nerella2/ECE445Journal/PCB/kb42nerella2_alarm.kicad_pcb

## KiCad design PCB/kb42nerella2_alarm.kicad_pcb (2024-12-12)

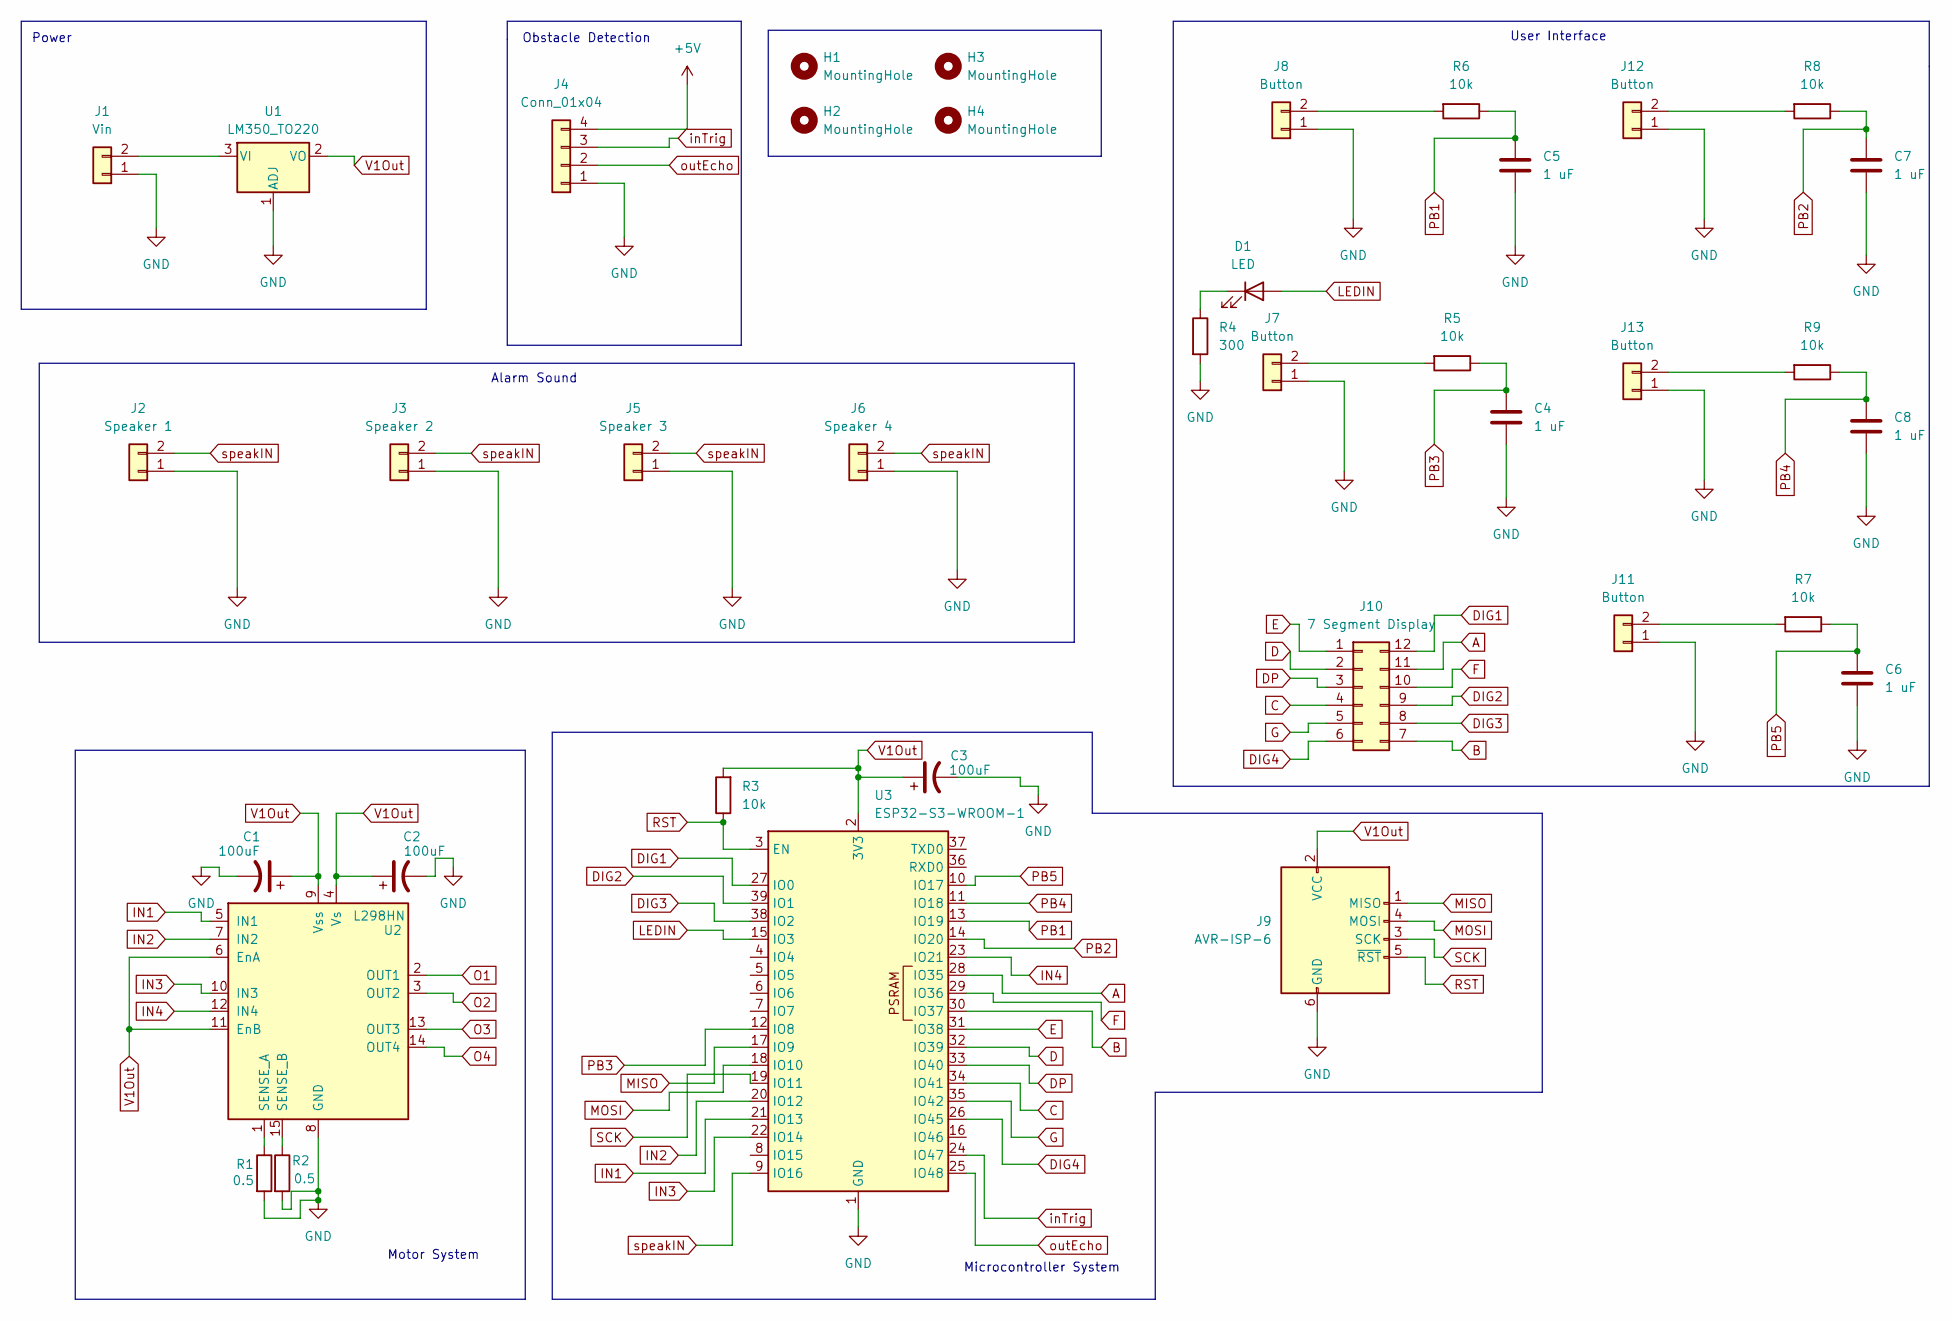
[picture p25: schematic kb42nerella2_alarm.kicad_sch]

Parts:
C1, C2, C3: 100uF; C_0805_2012Metric_Pad1.18x1.45mm_HandSolder
C4, C5, C6, C7, C8: 1 uF; C_0805_2012Metric_Pad1.18x1.45mm_HandSolder
D1: LED; Molex_KK-254_AE-6410-02A_1x02_P2.54mm_Vertical
H1, H2, H3, H4: MountingHole; MountingHole_3.2mm_M3
J1: Vin; Molex_KK-254_AE-6410-02A_1x02_P2.54mm_Vertical
J2: Speaker 1; Molex_KK-254_AE-6410-02A_1x02_P2.54mm_Vertical
J3: Speaker 2; Molex_KK-254_AE-6410-02A_1x02_P2.54mm_Vertical
J4: Conn_01x04; Molex_KK-254_AE-6410-04A_1x04_P2.54mm_Vertical
J5: Speaker 3; Molex_KK-254_AE-6410-02A_1x02_P2.54mm_Vertical
J6: Speaker 4; Molex_KK-254_AE-6410-02A_1x02_P2.54mm_Vertical
J7, J8, J11, J12, J13: Button; Molex_KK-254_AE-6410-02A_1x02_P2.54mm_Vertical
J9: AVR-ISP-6; IDC-Header_2x03_P2.54mm_Vertical
J10: 7 Segment Display; IDC-Header_2x06_P2.54mm_Vertical
R1, R2: 0.5; R_0805_2012Metric_Pad1.20x1.40mm_HandSolder
R3, R5, R6, R7, R8, R9: 10k; R_0805_2012Metric_Pad1.20x1.40mm_HandSolder
R4: 300; R_0805_2012Metric_Pad1.20x1.40mm_HandSolder
U1: LM350_TO220; TO-220-3_Vertical
U2: L298HN; TO-220-15_P2.54x2.54mm_StaggerOdd_Lead5.84mm_TabDown
U3: ESP32-S3-WROOM-1

Connections:
+5V: J4.4
A: J10.11, U3.28 (IO35)
B: J10.7, U3.30 (IO37)
C: J10.4, U3.34 (IO41)
D: J10.2, U3.32 (IO39)
DIG1: J10.12, U3.27 (IO0)
DIG2: J10.9, U3.39 (IO1)
DIG3: J10.8, U3.38 (IO2)
DIG4: J10.6, U3.26 (IO45)
DP: J10.3, U3.33 (IO40)
E: J10.1, U3.31 (IO38)
F: J10.10, U3.29 (IO36)
G: J10.5, U3.35 (IO42)
GND: C1.2, C2.2, C3.2, C4.2, C5.2, C6.2, C7.2, C8.2, J1.1, J2.1, J3.1, J4.1, J5.1, J6.1, J7.1, J8.1, J9.6 (GND), J11.1, J12.1, J13.1, R1.2, R2.2, R4.2, U1.1 (ADJ), U2.8 (GND), U3.1 (GND), U3.40 (GND), U3.41 (GND)
IN1: U2.5 (IN1), U3.21 (IO13)
IN2: U2.7 (IN2), U3.20 (IO12)
IN3: U2.10 (IN3), U3.22 (IO14)
IN4: U2.12 (IN4), U3.23 (IO21)
LEDIN: D1.2 (A), U3.15 (IO3)
MISO: J9.1 (MISO), U3.17 (IO9)
MOSI: J9.4 (MOSI), U3.18 (IO10)
unnamed: D1.1 (K), R4.1
unnamed: J1.2, U1.3 (VI)
unnamed: J7.2, R5.2
unnamed: J8.2, R6.2
unnamed: J11.2, R7.2
unnamed: J12.2, R8.2
unnamed: J13.2, R9.2
unnamed: R1.1, U2.1 (SENSE_A)
unnamed: R2.1, U2.15 (SENSE_B)
O1: U2.2 (OUT1)
O2: U2.3 (OUT2)
O3: U2.13 (OUT3)
O4: U2.14 (OUT4)
PB1: C5.1, R6.1, U3.13 (IO19)
PB2: C7.1, R8.1, U3.14 (IO20)
PB3: C4.1, R5.1, U3.12 (IO8)
PB4: C8.1, R9.1, U3.11 (IO18)
PB5: C6.1, R7.1, U3.10 (IO17)
RST: J9.5 (~RST), R3.1, U3.3 (EN)
SCK: J9.3 (SCK), U3.19 (IO11)
V1Out: C1.1, C2.1, C3.1, J9.2 (VCC), R3.2, U1.2 (VO), U2.4 (Vs), U2.6 (EnA), U2.9 (Vss), U2.11 (EnB), U3.2 (3V3)
inTrig: J4.3, U3.24 (IO47)
outEcho: J4.2, U3.25 (IO48)
speakIN: J2.2, J3.2, J5.2, J6.2, U3.9 (IO16)

Notes on the sheet:
Alarm Sound
Microcontroller System
Motor System
User Interface
Power
Obstacle Detection

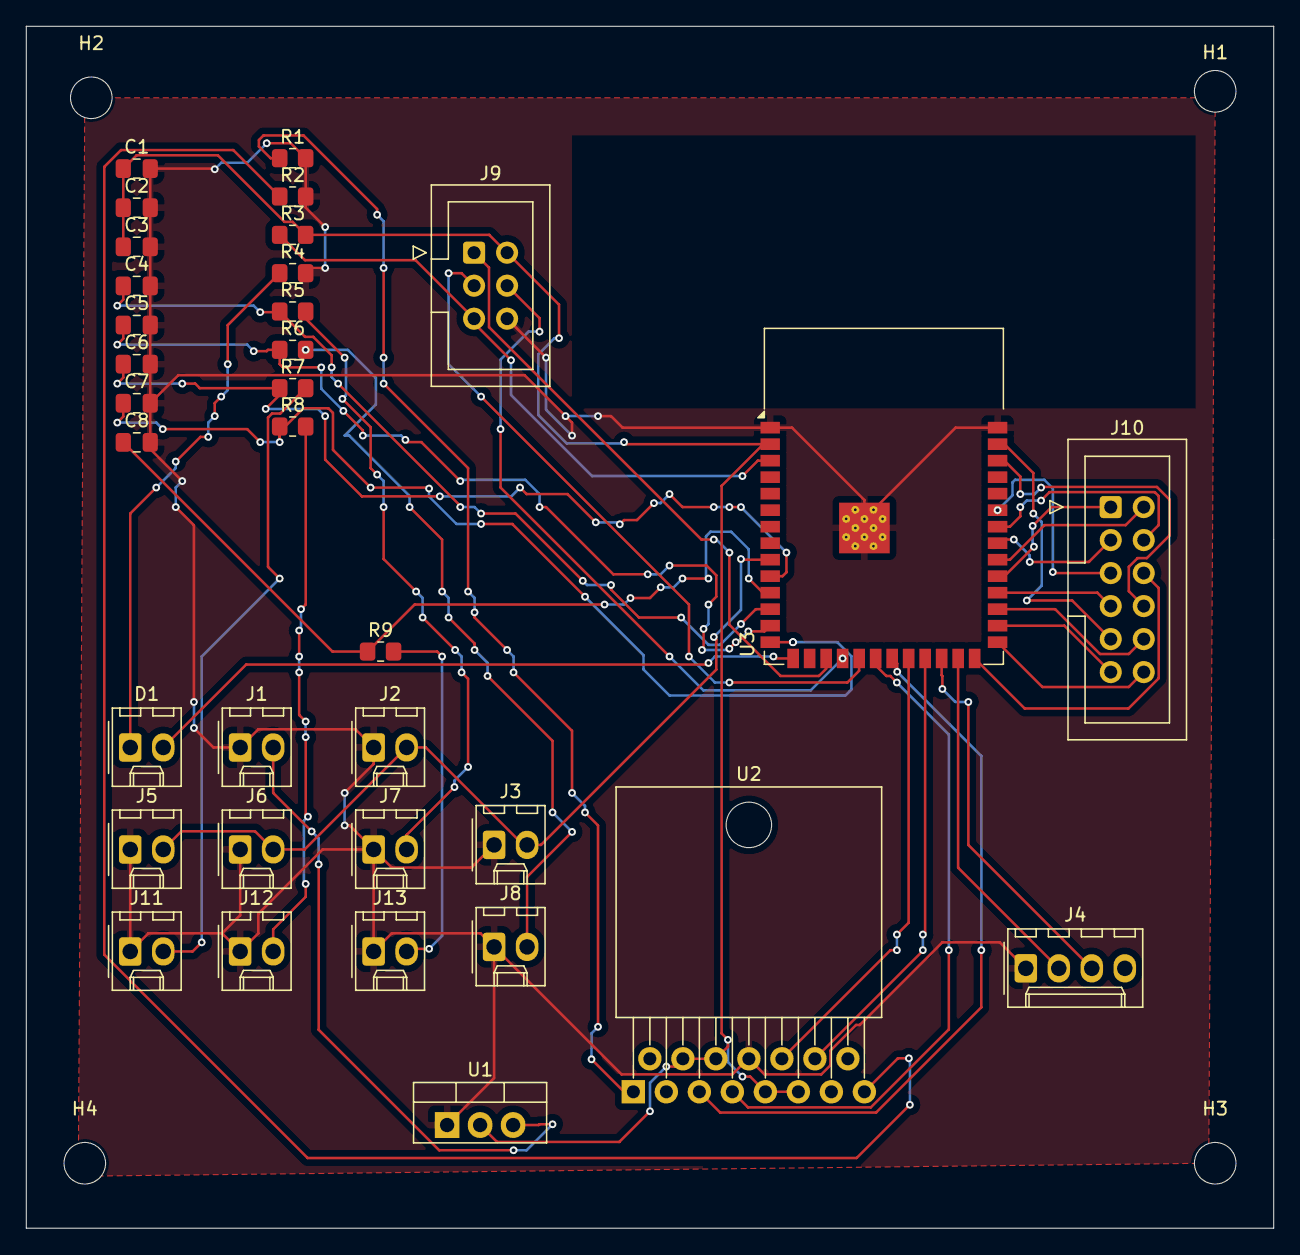
[picture p26: board kb42nerella2_alarm.kicad_pcb from above]

Board: 2 copper layers, 96.0 x 92.5 mm, 38 parts (0 on the bottom side), 40 nets.
